ElectronicCats/badge-ekoparty2023/README.md

# EKO Badge 2023

El primer badge oficial de la EKO Party!

## Características

- Procesador RISC V
- I2C
- UART
- CAN
- Bluetooth
- Baterias AA
## Crea tu propio firmware
En la carpeta firmware_test hemos dejado un ejemplo de como puedes utilizar las funciones basicas del badge

- Ahora puedes controlar los LEDs
- Puedes controlar BLE
- Puedes controlar la OLED

Puedes hacer mucho mas, solo es cuestion de tu imaginacion y que tanta documentacion puedas leer en tres dias, el badge cuenta con el chip CH32V208CBU6 de WCH algunas de las cosas interesantes de este chip son:

- Comunicacion:
  - BLE
  - I2C
  - Serial
  - SPI
  - CAN
  - y otros GPIOs

 ## Links de interes

- Datasheet: [Hoja de datos](https://www.wch-ic.com/products/CH32V208.html)
- SDK: [OpenWCH CH32v20x](https://github.com/openwch/ch32v20x)
- MountRiver: [IDE MountRiver](http://www.mounriver.com/)

## Crear tu propia máscara
Una de las características más emocionantes de nuestro EKOBadge es la capacidad de crear tu propia máscara. Visualmente, su aspecto es único, y para fomentar la creatividad de la comunidad, hemos diseñado una máscara que puedes modificar según tu personalidad.

El badge cuenta con un accesorio que hemos llamado la "Mascara" que puede modificar visualmente su aspecto, hemos liberado el diseño porque queremos la comunidad pueda crear sus propias máscaras según su personalidad. 

Hemos dejado los archivos necesarios con las medidas para que puedas diseñar tu propia máscara para el EKOBadge. ¡Esperamos ver diseños geniales! Te retamos a hacer la mejor máscara.

**IMPORTANTE:**
- Grosor o PCB Thickness de la PCB es de 0.6

### Software necesario

Para facilitar el proceso, necesitarás ciertas herramientas. Puedes utilizar KiCad para el diseño de PCB y Inkscape para la creación de gráficos. Además, te recomendamos el uso de evg2shenzhen o svgtomod. Todos los enlaces a estas herramientas se encuentran en la descripción.

- [KiCad](https://www.kicad.org/) 
- [Inskcape](https://inkscape.org/es/)
- [svg2shenzhen](https://github.com/badgeek/svg2shenzhen)

o también puedes utilizar

- [svgtomod](https://github.com/mtl/svg2mod) 

¿Quieres presumir tu creación? ¡Compártela con nosotros en las redes sociales de ekoparty y Electronicats! Estamos ansiosos por ver tus diseños únicos.

## Preguntas Frecuentes

- **¿Cómo es el badge?** 

  Eso es algo que tendrás que esperar a descubrir hasta el día del evento

- **¿Va a haber un lugar para modificar el badge?** 

 ¡Nos vemos en la villa de hardware!

- **¿Dónde puede hacer mis PCBs de la máscara?** 

  Te dejamos algunos lugares recomendados:
  [PCBWay](https://www.pcbway.com/), [JLCPCB](https://jlcpcb.com/) o algún otro fabricante de PCB

Si tienes alguna duda sobre cómo crear tu máscara, no dudes en abrir un issue.

## License
<a>
  
</a>

Diseñado por Electronic Cats para EKO Party

Electronic Cats invests time and resources in providing this open-source design. Please support Electronic Cats and open-source hardware by purchasing products from Electronic Cats!

Hardware released under an CERN Open Hardware Licence v1.2. See the LICENSE_HARDWARE file for more information.

Electronic Cats and EKO Party is a registered trademark. Please do not use if you sell these PCBs.

Sept 2023
