ElectronicCats/badge-ekoparty2023/(commit log)

2023-06-23 Starting the schematic
    [ekoparty2023.kicad_pcb, ekoparty2023.kicad_sch]
2023-06-30 Neopixels, battery, OLED screen and buttons added
    [ekoparty2023.kicad_sch]
2023-07-04 SWD added, assigned Neopixel and OLED screen
    [ekoparty2023.kicad_sch]
2023-07-12 Manufacturing numbers and footprints added
    [ekoparty2023.kicad_sch]
2023-07-14 Starting proposal of accommodation in the badge
    [ekoparty2023.kicad_pcb, ekoparty2023.kicad_sch]
2023-07-18 Enlarged badge shape and all 3D models added
    [ekoparty2023.kicad_pcb, ekoparty2023.kicad_sch]
2023-07-19 Created board that goes on top of the Ekoparty board
    [ekoparty2023.kicad_pcb, topekoparty.kicad_pcb, topekoparty.kicad_sch]
2023-07-20 Pins assigned to buttons and neopixels
    [ekoparty2023.kicad_pcb, ekoparty2023.kicad_sch]
2023-07-28 Change the design of the top part of the badge
    [ekoparty2023.kicad_pcb, topekoparty.kicad_pcb]
2023-07-28 Starting to route
    [ekoparty2023.kicad_pcb, ekoparty2023.kicad_sch, topekoparty.kicad_pcb]
2023-08-01 Finished routing
    [ekoparty2023.kicad_pcb, ekoparty2023.kicad_sch]
2023-08-02 Routing corrected
    [ekoparty2023.kicad_pcb, ekoparty2023.kicad_sch]
2023-08-04 Chip moved for antenna routing correction
    [ekoparty2023.kicad_pcb, ekoparty2023.kicad_sch]
2023-08-08 Update GND shielding vias
    [ekoparty2023.kicad_pcb]
2023-08-08 fix traces with minimum clearence
    [ekoparty2023.kicad_pcb]
2023-08-08 add logos
    [ekoparty2023.kicad_pcb]
2023-08-08 Enlarged badge holes
    [ekoparty2023.kicad_pcb]
2023-08-08 BOM generated
    [ekoparty2023.csv]
2023-08-08 add beta version
    [ekoparty2023.kicad_pcb]
2023-08-08 GND of antenna added
    [ekoparty2023.kicad_pcb]
2023-08-09 Chip corrections and new routing
    [ekoparty2023.kicad_pcb, ekoparty2023.kicad_sch]
2023-08-09 Source tracks changed
    [ekoparty2023.kicad_pcb]
2023-08-10 add copper to the top badge
    [topekoparty.kicad_pcb]
2023-08-23 EdgeCut ok
    [ekoparty2023.kicad_pcb]
2023-08-24 hanging hole moved up and started modification of top part of the badge
    [ekoparty2023.kicad_pcb, topekoparty.kicad_pcb]
2023-08-25 Top part of badge reduced
    [topekoparty.kicad_pcb]
2023-08-30 Labels edited and J3 changed
    [ekoparty2023.kicad_pcb, ekoparty2023.kicad_sch]
2023-08-30 Top of founder, EC and staff added
    [TopEC.kicad_pcb, TopEC.kicad_sch, TopFounder.kicad_pcb, TopFounder.kicad_sch, TopStaff.kicad_pcb, TopStaff.kicad_sch, ekoparty2023.kicad_pcb, topekoparty.kicad_pcb]
2023-09-12 Connector with serial and i2c added
    [ekoparty2023.kicad_pcb, ekoparty2023.kicad_sch]
2023-09-13 Connector routed and BOM changed
    [ekoparty2023.csv, ekoparty2023.kicad_pcb, ekoparty2023.kicad_sch]
2023-09-13 DNP placed
    [ekoparty2023.csv, ekoparty2023.kicad_sch]
2023-09-13 change 3D and footprints for LEDs better routing
    [ekoparty2023.kicad_pcb, ekoparty2023.kicad_sch]
2023-09-13 update switch position and routing
    [ekoparty2023.kicad_pcb]
2023-09-14 Add i2c test
2023-09-14 Crystals changed
    [ekoparty2023.csv, ekoparty2023.kicad_pcb, ekoparty2023.kicad_sch]
2023-09-18 Reestablished crystals
    [ekoparty2023.kicad_pcb, ekoparty2023.kicad_sch]
2023-09-18 refactor: use i2c2 instead of i2c1
2023-09-18 Change pin of neopixel to PA7
    [ekoparty2023.kicad_pcb, ekoparty2023.kicad_sch]
2023-09-18 change silkscreen of buttons
    [ekoparty2023.kicad_pcb]
2023-09-19 update holes for mask
    [ekoparty2023.kicad_pcb]
2023-09-20 Show last image before power off
2023-09-20 Fix i2c init
2023-09-27 Add leds api
2023-09-28 Add led tests
2023-10-11 Enable buttons
2023-10-13 Move option selector with buttons
2023-10-22 Add auto connection to nearby devices
2023-10-23 Add filter to friends counter
2023-10-24 Verify if nearby device is already in friends list
2023-10-26 Add cycling sensor
2023-11-01 Remove prints
2023-11-29 Update examples and License
    [topekoparty.kicad_pcb, topekoparty.kicad_sch]
